PyCubed-Mini/avionics-solarpanels/README.md

# Solar Panels
PyCubedMini Solar Panel KiCAD projects.
