PyCubed-Mini/avionics-solarpanels/Solar-Panel-X (4L)/Solar-Panel-X.step

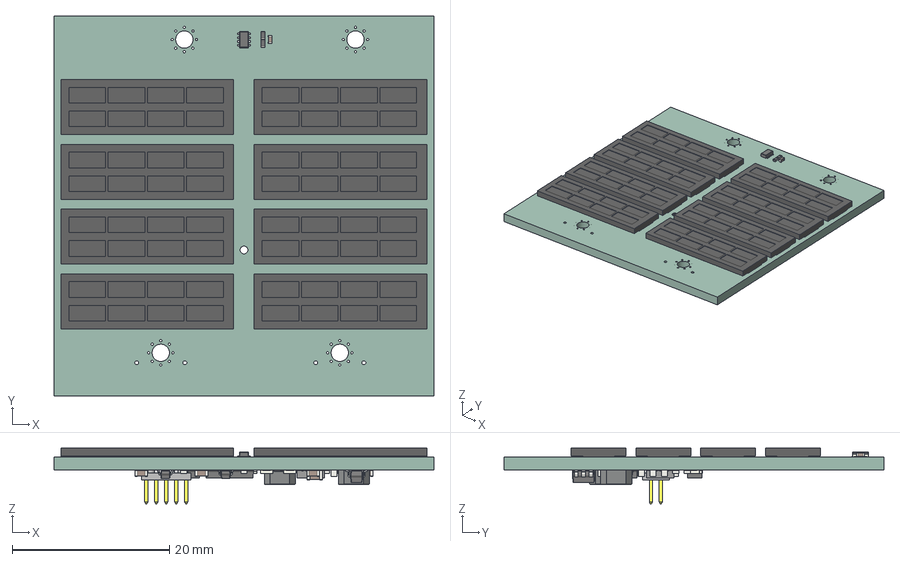
[picture p1: CAD file, 2023-06-21]
Solar-Panel-X (4L)/Solar-Panel-X.step
48.4 x 48.4 x 7.09 mm
Solar-Panel-X PCB
