PyCubed-Mini/avionics-solarpanels/Solar-Panel-X/Solar-Panel-X.step

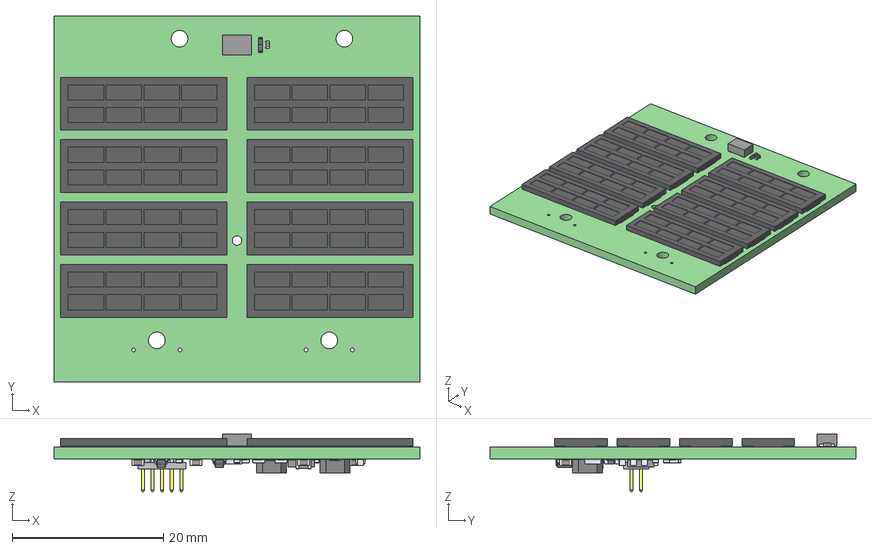
[picture p2: CAD file, 2022-12-01]
Solar-Panel-X/Solar-Panel-X.step
48.4 x 48.4 x 7.64 mm
Solar-Panel-X PCB
