PyCubed-Mini/avionics-solarpanels/Solar-Panel-Y+ (4L)/Solar-Panel-Y+.step

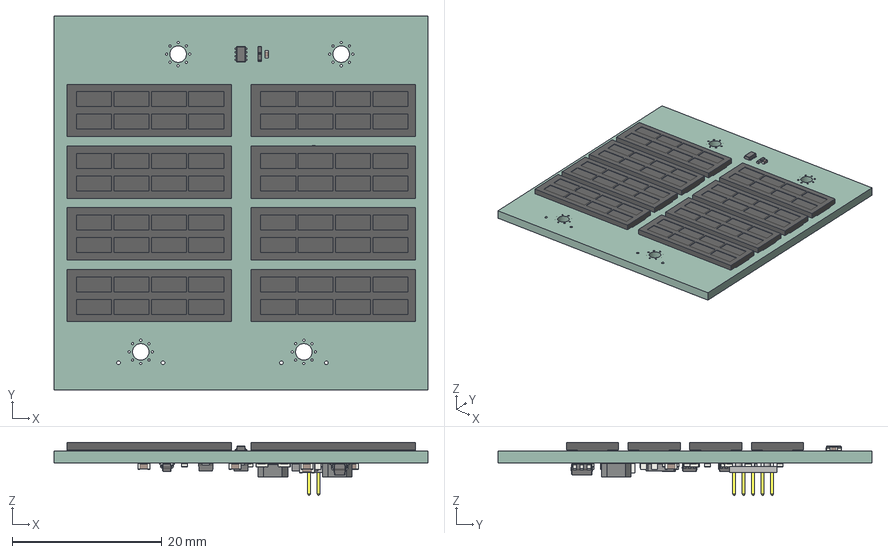
[picture p3: CAD file, 2023-06-21]
Solar-Panel-Y+ (4L)/Solar-Panel-Y+.step
50.0 x 50.0 x 7.09 mm
Solar-Panel-Y+ PCB
