PyCubed-Mini/avionics-solarpanels/Solar-Panel-Y+/Solar-Panel-Y+.step

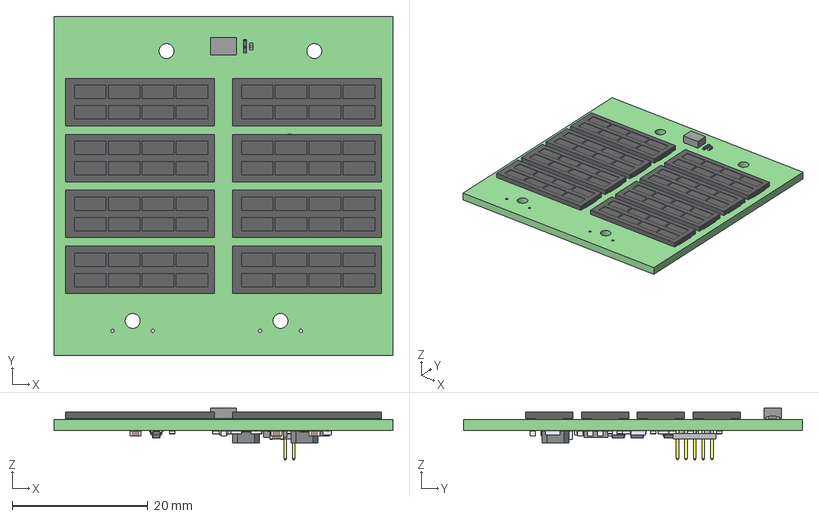
[picture p4: CAD file, 2022-12-01]
Solar-Panel-Y+/Solar-Panel-Y+.step
50.0 x 50.0 x 7.64 mm
Solar-Panel-Y+ PCB
