PyCubed-Mini/avionics-solarpanels/Solar-Panel-Z+ (4L)/Solar-Panel-Z+.step

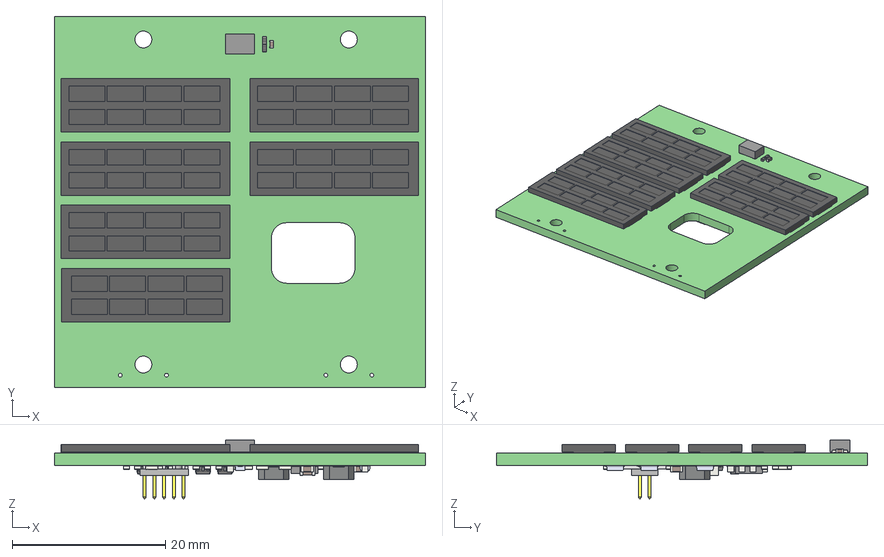
[picture p5: CAD file, 2022-12-01]
Solar-Panel-Z+ (4L)/Solar-Panel-Z+.step
48.4 x 48.4 x 7.64 mm
Solar-Panel-Z+ PCB
