PyCubed-Mini/avionics-solarpanels/Solar-Panel-Z+/Solar-Panel-Z+ Keepout.dxf

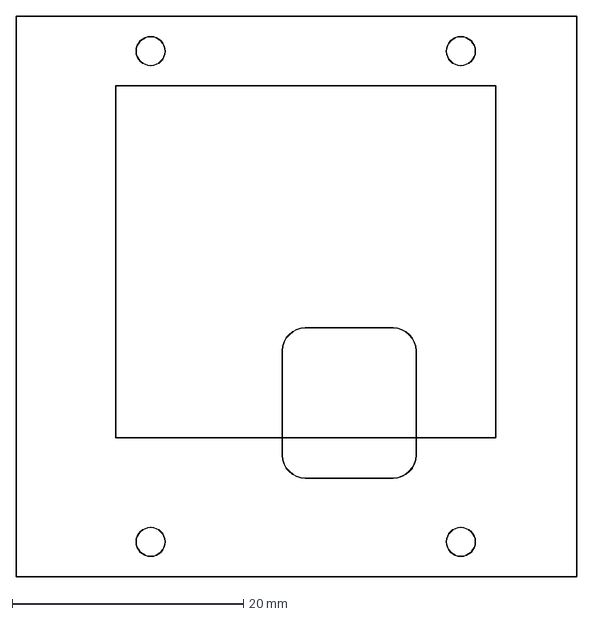
[picture p6: CAD file, 2022-08-09]
Solar-Panel-Z+/Solar-Panel-Z+ Keepout.dxf
48.4 x 48.4 mm
