PyCubed-Mini/avionics-solarpanels/Solar-Panel-Z+ (4L)/Solar-Panel-Z+.kicad_pcb

## KiCad design Solar-Panel-Z+ (4L)/Solar-Panel-Z+.kicad_pcb (2023-06-21)

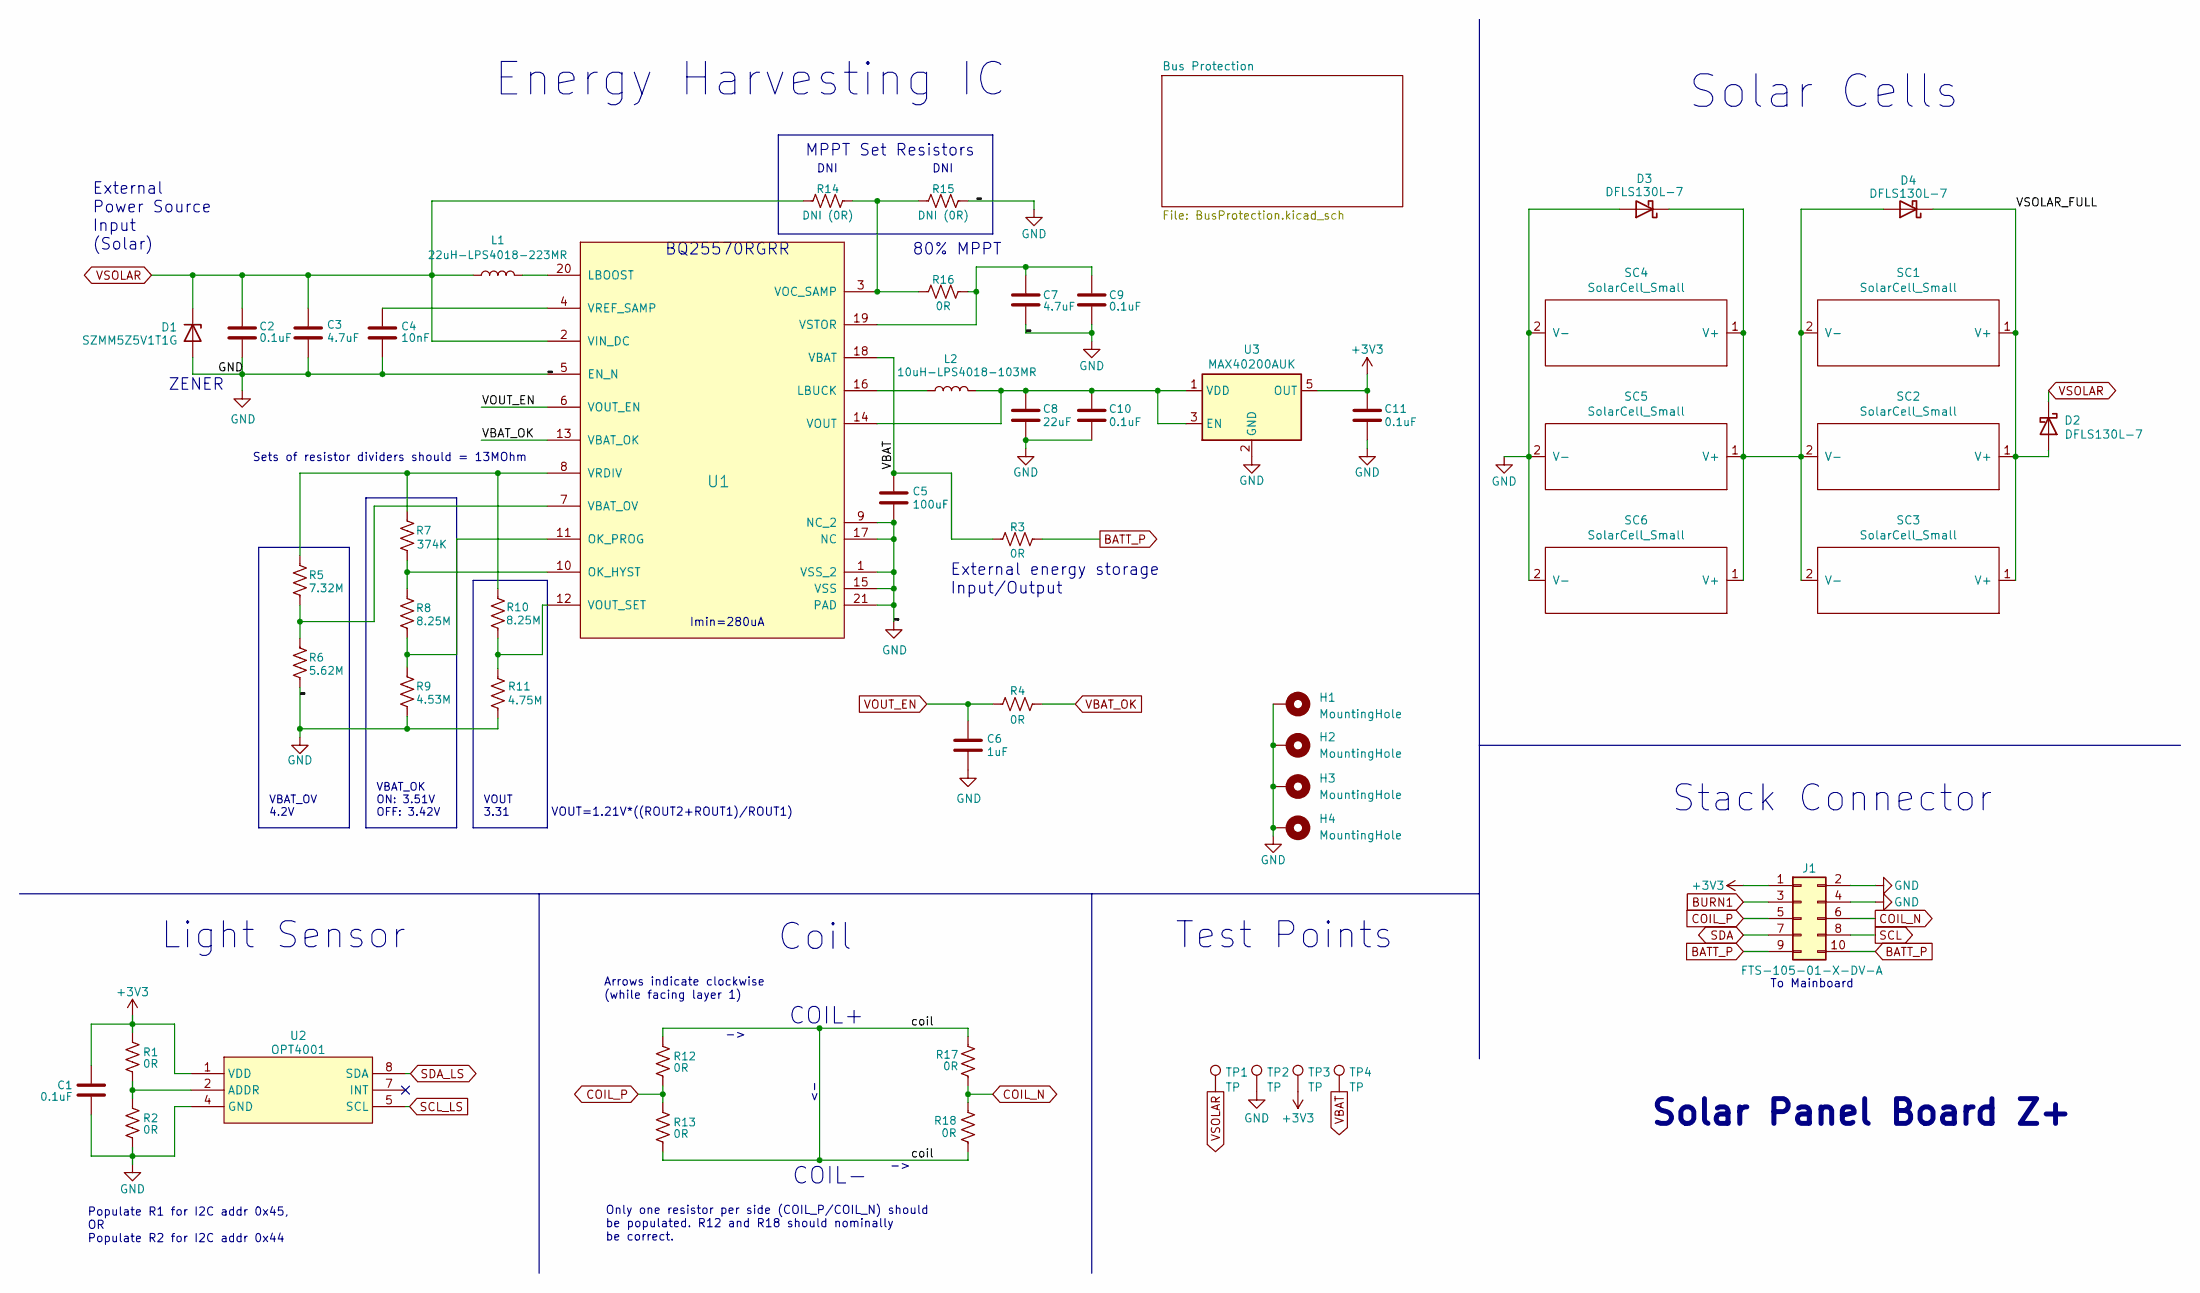
[picture p7: schematic Solar-Panel-Z+.kicad_sch, PyCubed Mini]

Parts:
C1: 0.1uF; C_0402_1005Metric
C2, C9, C10, C11: 0.1uF; C_0603_1608Metric
C3, C7: 4.7uF; C_0603_1608Metric
C4: 10nF; C_0603_1608Metric
C5: 100uF; C_0805_2012Metric
C6: 1uF; C_0603_1608Metric
C8: 22uF; C_0603_1608Metric
D1: SZMM5Z5V1T1G; D_SOD-523
D2, D3, D4: DFLS130L-7; D_PowerDI-123
H1, H2, H3, H4: MountingHole; MountingHole_2.2mm_M2_DIN965_Pad_TopBottom
J1: FTS-105-01-X-DV-A; SAMTEC-FTS-105-01-X-DV-A
L1: 22uH-LPS4018-223MR; LPS4018
L2: 10uH-LPS4018-103MR; LPS4018
R1, R2: 0R; R_0402_1005Metric
R3, R4, R12, R13, R16, R17, R18: 0R; R_0603_1608Metric
R5: 7.32M; R_0603_1608Metric
R6: 5.62M; R_0603_1608Metric
R7: 374K; R_0603_1608Metric
R8, R10: 8.25M; R_0603_1608Metric
R9: 4.53M; R_0603_1608Metric
R11: 4.75M; R_0603_1608Metric
R14, R15: DNI (0R); R_0603_1608Metric
SC1, SC2, SC3, SC4, SC5, SC6: SolarCell_Small; KXOB25-05X3F
TP1, TP2, TP3, TP4: TP; TestPoint_THTPad_D1.0mm_Drill0.5mm
U1: BQ25570RGRR; QFN50P350X350X100-21N-D
U2: OPT4001; SOT-583-8
U3: MAX40200AUK; SOT-23-5

Connections:
+3V3: C1.2, C11.1, J1.1, R1.2, TP3.1, U2.1 (VDD), U3.5 (OUT); also elsewhere on the board
/VSOLAR_FULL: D2.2 (A), D4.1 (K), SC1.1 (V+), SC2.1 (V+), SC3.1 (V+)
/coil: R12.2, R13.1, R17.2, R18.1
BATT_P: J1.9, J1.10, R3.1
BURN1: J1.3
COIL_N: J1.6, R17.1, R18.2
COIL_P: J1.5, R12.1, R13.2
GND: C1.1, C2.2, C3.2, C4.2, C5.2, C6.2, C7.2, C8.2, C9.2, C10.2, C11.2, D1.2 (A), D3.2 (A), H1.1, H2.1, H3.1, H4.1, J1.2, J1.4, R2.1, R6.1, R9.1, R11.1, R15.1, SC4.2 (V-), SC5.2 (V-), SC6.2 (V-), TP2.1, U1.1 (VSS_2), U1.5 (EN_N), U1.9 (NC_2), U1.15 (VSS), U1.17 (NC), U1.21 (PAD), U2.4 (GND), U3.2 (GND); also elsewhere on the board
unnamed: D3.1 (K), D4.2 (A), SC1.2 (V-), SC2.2 (V-), SC3.2 (V-), SC4.1 (V+), SC5.1 (V+), SC6.1 (V+)
unnamed: L1.2, U1.20 (LBOOST)
unnamed: L2.1, U1.16 (LBUCK)
unnamed: R7.1, R8.2, U1.10 (OK_HYST)
unnamed: R8.1, R9.2, U1.11 (OK_PROG)
unnamed: R5.1, R6.2, U1.7 (VBAT_OV)
unnamed: R14.1, R15.2, R16.2, U1.3 (VOC_SAMP)
unnamed: C8.1, C10.1, L2.2, U1.14 (VOUT), U3.1 (VDD), U3.3 (EN)
unnamed: R10.1, R11.2, U1.12 (VOUT_SET)
unnamed: R5.2, R7.2, R10.2, U1.8 (VRDIV)
unnamed: C4.1, U1.4 (VREF_SAMP)
unnamed: C7.1, C9.1, R16.1, U1.19 (VSTOR)
unnamed: R1.1, R2.2, U2.2 (ADDR)
SCL: J1.8; also elsewhere on the board
SCL_LS: U2.5 (SCL); also elsewhere on the board
SDA: J1.7; also elsewhere on the board
SDA_LS: U2.8 (SDA); also elsewhere on the board
VBAT: C5.1, R3.2, TP4.1, U1.18 (VBAT)
VBAT_OK: R4.1, U1.13 (VBAT_OK)
VOUT_EN: C6.1, R4.2, U1.6 (VOUT_EN)
VSOLAR: C2.1, C3.1, D1.1 (K), D2.1 (K), L1.1, R14.2, TP1.1, U1.2 (VIN_DC)

Notes on the sheet:
80% MPPT
DNI
Populate R1 for I2C addr 0x45, OR Populate R2 for I2C addr 0x44
Solar Cells
External Power Source Input (Solar)
Only one resistor per side (COIL_P/COIL_N) should be populated. R12 and R18 should nominally be correct.
Stack Connector
VOUT 3.31
Energy Harvesting IC
MPPT Set Resistors
Arrows indicate clockwise (while facing layer 1)
To Mainboard
Test Points
External energy storage Input/Output
COIL+
BQ25570RGRR
Light Sensor
Solar Panel Board Z+
VOUT=1.21V*((ROUT2+ROUT1)/ROUT1)
VBAT_OV 4.2V
VBAT_OK ON: 3.51V OFF: 3.42V
COIL-
Sets of resistor dividers should = 13MOhm
Imin=280uA
ZENER
Coil

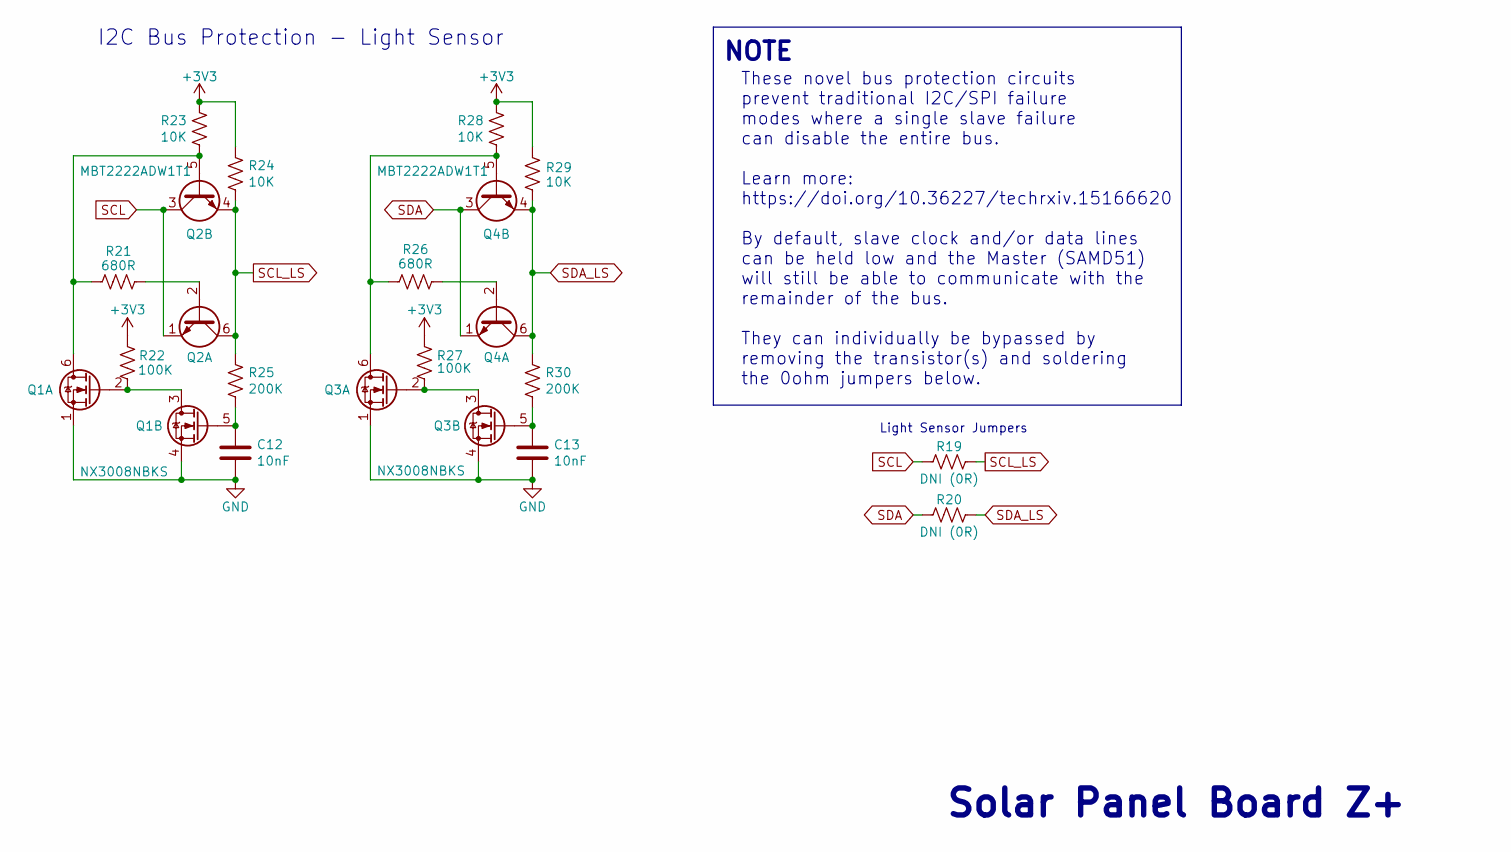
[picture p8: schematic BusProtection.kicad_sch, PyCubed Mini]

Parts:
C12, C13: 10nF; C_0603_1608Metric
Q1, Q3: NX3008NBKS; SOT-363_SC-70-6; Manufacturer_Part_Number NX3008NBKS
Q2, Q4: MBT2222ADW1T1; SOT-363_SC-70-6; Manufacturer_Part_Number MBT2222ADW1T1G
R19, R20: DNI (0R); R_0603_1608Metric
R21, R26: 680R; R_0603_1608Metric
R22, R27: 100K; R_0603_1608Metric
R23, R24, R28, R29: 10K; R_0603_1608Metric
R25, R30: 200K; R_0603_1608Metric

Connections:
+3V3: R22.1, R23.1, R24.1, R27.1, R28.1, R29.1; also elsewhere on the board
GND: C12.2, C13.2, Q1.1 (S2), Q1.4 (S1), Q3.1 (S2), Q3.4 (S1); also elsewhere on the board
unnamed: Q1.6 (D1), Q2.5 (B2), R21.2, R23.2
unnamed: Q1.2 (G2), Q1.3 (D2), R22.2
unnamed: C12.1, Q1.5 (G1), R25.2
unnamed: Q2.2 (B1), R21.1
unnamed: Q3.6 (D1), Q4.5 (B2), R26.2, R28.2
unnamed: Q3.2 (G2), Q3.3 (D2), R27.2
unnamed: C13.1, Q3.5 (G1), R30.2
unnamed: Q4.2 (B1), R26.1
SCL: Q2.1 (E1), Q2.3 (C2), R19.2; also elsewhere on the board
SCL_LS: Q2.4 (E2), Q2.6 (C1), R19.1, R24.2, R25.1; also elsewhere on the board
SDA: Q4.1 (E1), Q4.3 (C2), R20.2; also elsewhere on the board
SDA_LS: Q4.4 (E2), Q4.6 (C1), R20.1, R29.2, R30.1; also elsewhere on the board

Notes on the sheet:
Light Sensor Jumpers
These novel bus protection circuits prevent traditional I2C/SPI failure modes where a single slave failure can disable the entire bus. Learn more: https://doi.org/10.36227/techrxiv.15166620 By default, slave clock and/or data lines can be held low and the Master (SAMD51) will still be able to commu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
NOTE
I2C Bus Protection - Light Sensor
Solar Panel Board Z+

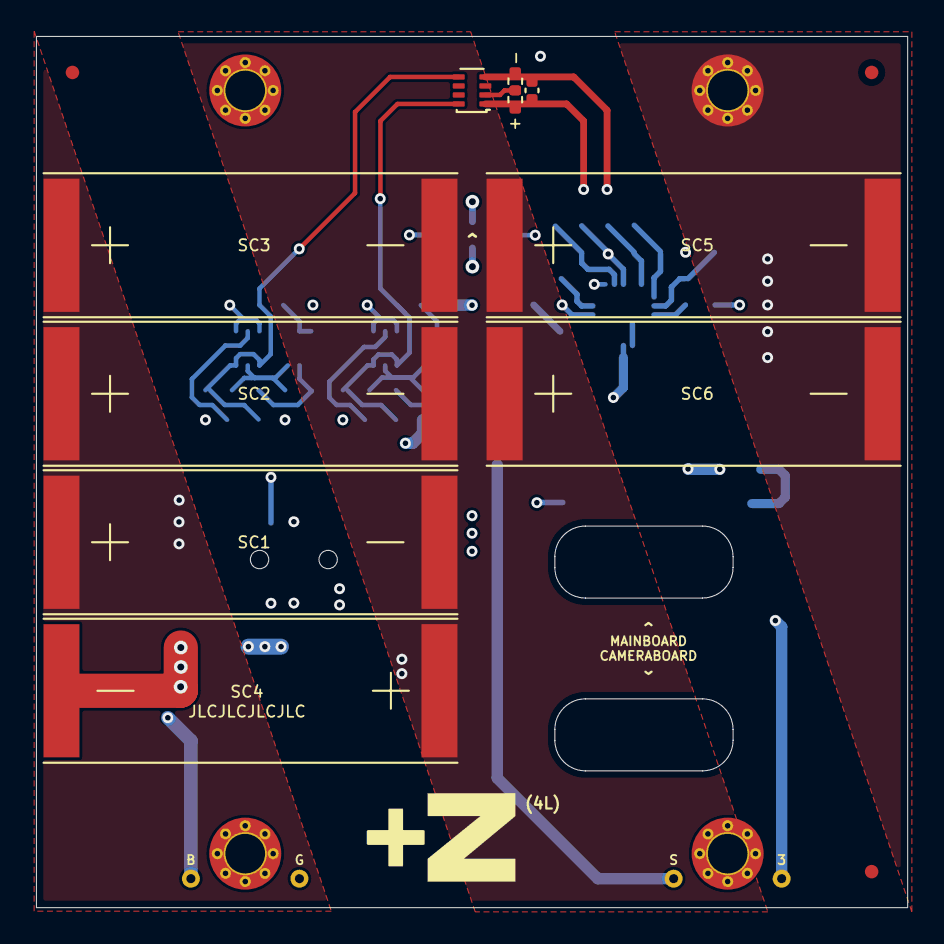
[picture p9: board Solar-Panel-Z+.kicad_pcb from above]

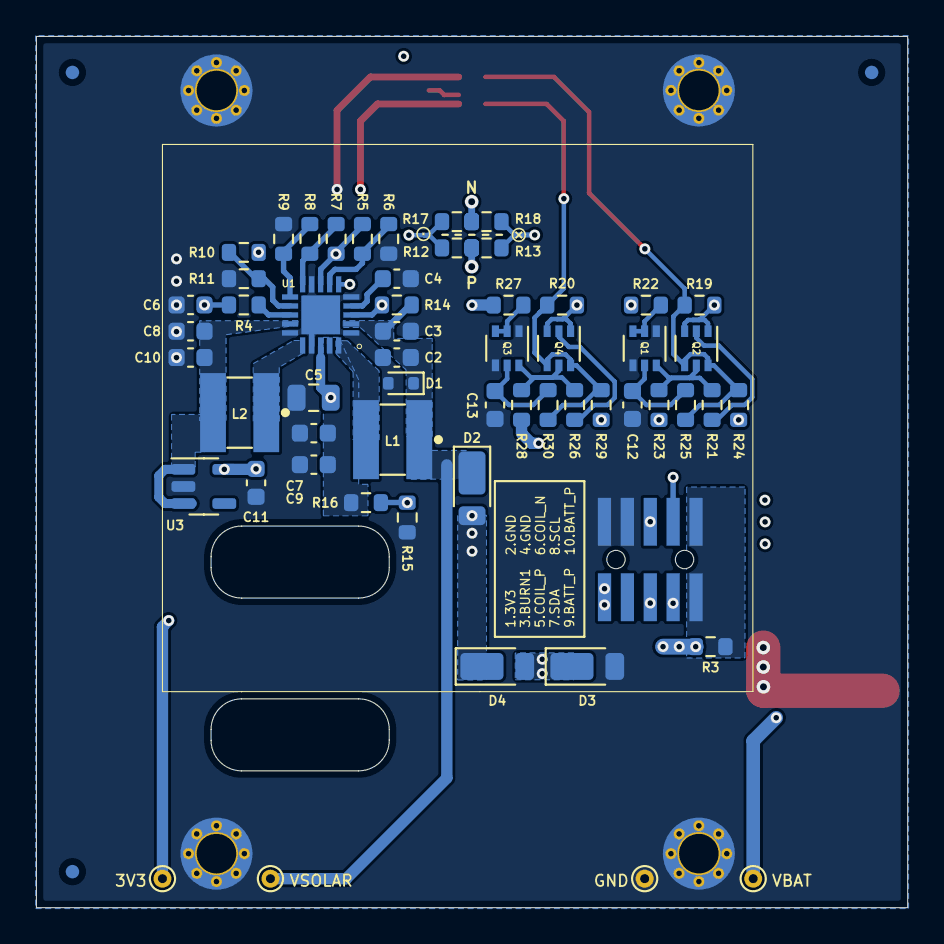
[picture p10: board Solar-Panel-Z+.kicad_pcb from below]

Board: 4 copper layers, 48.4 x 48.4 mm, 73 parts (58 on the bottom side), 36 nets.

Other parts of the board:
Ref**: Val**; ypanel
Ref**#2: Val**; pycubed_mini_half
