PyCubed-Mini/avionics-solarpanels/(threads)

Thread 2 (2022-02-15):

Initial electrical power-on test

jbwillis, 2022-02-15:
Test current board revisions by doing a flatsat assembly. Start by powering on the avionics board and seeing what runs, then connect each of the solar boards individually, then all of them together.

Closed 2022-06-13.

Thread 3 (2022-02-15):

Remove S-Band radio

jbwillis, 2022-02-15:

NeilKhera, 2022-02-28:
I assume this refers to the radio/antenna on the -Y board? Potentially addressed in #15

jbwillis, 2022-02-28:
Yes, that is correct.

Closed 2022-03-16.

Thread 4 (2022-02-15):

Consider adding GNSS

jbwillis, 2022-02-15:
Need to do a power analysis to see if we can even operate a GNSS antenna to make this work

jbwillis, 2022-02-22:
After a conversation with Zac, it sounds like we can rely on ground updates of the location and propagation using a clock.

Thread 6 (2022-02-15):

Determine status of current PCBs

jbwillis, 2022-02-15:
Compare the latest revision PCBs that we have with the schematics - determine if PCBs are up to date with the schematics.

Closed 2022-02-22.

Thread 8 (2022-02-15):

Battery harness redesign

jbwillis, 2022-02-15:
The current battery harness is bulky and time consuming to build, mostly due to having to route wires between each set of batteries. A revision of the battery harness, possibly including some small PCBs, would allow for easier construction and testing of the batteries.

jbwillis, 2022-02-22:
Some more thoughts and questions on how to do this.

- [ ] Could we use only one type of battery? The more square ones are 150 mAh and seem to fit into the space better.
- [ ] Solder two batteries to a little circuit board that plugs into the -Y board?

jbwillis, 2022-02-23:
Another idea - solder two batteries to the bottom half of each of the X and Z boards, getting rid of the battery donut entirely. This would require adding another power signal to the FFC to take power from the batteries to the sep switches. Bad idea? maybe.

NeilKhera, 2022-08-31:
Solved with Revision B

Closed 2022-08-31.

Thread 10 (2022-02-22):

Antenna redesign

jbwillis, 2022-02-22:

NeilKhera, 2022-02-28:
Do you have more info about this?

Closed 2022-05-24.

Thread 11 (2022-02-22):

Remove burn wire circuitry on Z boards?

jbwillis, 2022-02-22:
The burn circuit is currently unused on the Z board and it takes up valuable real estate. Consider removing it if possible

NeilKhera, 2022-02-27:
Should I proceed with this?

NeilKhera, 2022-02-28:
Done in #15. Will revert if necessary.

Closed 2022-03-16.

Thread 9 (2022-02-22):

Z Board access hole resize

jbwillis, 2022-02-22:
Need to make the access hole larger to enable easier access to USB port and to allow access to camera USB port.

- [ ] can we remove the fiducials on the z board and shift the solar panels all the way to the edge of the PCB?
- [ ] Extend hole down to even with solar cell below the hole.
- [ ] Make hole wider in each direction.

jbwillis, 2022-02-23:
This is also going to impact the magnetorquer coil routing on the Z board. However, I noticed that the Z coils stay within the mounting holes, whereas the X wrap around the outside of the mounting holes. So, the Z coils could wrap outside the holes, which would reduce the impact of the access hole.

NeilKhera, 2022-02-28:
I don't love the idea of have a big hole on two sides of the sat. Seems like a bad idea for contaminants and such entering the inner boards? Could we instead try to have some sort of external utility port which we can hook up to and breakout whatever we need?

jbwillis, 2022-02-28:
That's an interesting idea. It's pretty standard for cubesats to have one of these holes. I don't think there is a huge contaminant problem for us - I could see that being an issue for something like MoonRanger though. We also already have a massive hole that the camera protrudes through, so I'm not sure how much we'd gain by avoiding that on the Z board. Adding an external interface also adds extra complications for assembly and testing. Let's discuss this with @zacmanchester to get his final word.

Closed 2022-03-16.

Thread 12 (2022-02-23):

Flat Flex Connector Relocation

jbwillis, 2022-02-23:
Redesign the flat flex cable so it is easier to route.

- [x] Orient FFC connectors on the X and Z boards so they point towards +Y
- [x] Move FFC connector on -Y board so it doesn't interfere with battery box. Orient it so it points towards one of the outside edges. Probably best to have it point towards one of the X edges since the Z sides are more crowded.
- [x] Update 3D model with all revised boards and route flat flex cable - minimize bends/contorsions
- [ ] Revise flat flex cable circuit design

NeilKhera, 2022-02-28:
Relocation addressed in #15

Closed 2022-05-13.

Thread 13 (2022-02-23):

Z Board Component interference

jbwillis, 2022-02-23:
Capacitor C11 on Z board interferes with current battery donut. All components need to be shifted up (pcb coordinate -Y direction) by 3mm minimum (this may increase more)

NeilKhera, 2022-02-28:
Addressed in #15

Closed 2022-03-16.

Thread 14 (2022-02-23):

Burn wire holes on +Y board interfere with Z board

jbwillis, 2022-02-23:
Burn wire holes on +Y board should be shifted in to avoid interfering with Z board overlap. Shift in (pcb coordinates) 1mm in -X direction.

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

NeilKhera, 2022-02-28:
Addressed in #15

Closed 2022-03-16.

Thread 16 (2022-05-19):

Antenna RF test

jbwillis, 2022-05-19:
- [ ] Assemble RF and burn wire components on the -Z solar board
- [ ] Connect to mainboard
- [ ] Test transmitting in the lab using the antenna

NeilKhera, 2022-12-01:
Can we close this?

Closed 2022-12-28.

Thread 17 (2022-05-19):

Antenna burn wire test

jbwillis, 2022-05-19:
- [x] Assemble antennas and burn wire components on -Z board
- [x] Attach solar board to mainboard
- [x] Run code to activate burn wire
- [x] Check if burn wire is operating (loop some fishing line through the burn wire, add some tension, and see if it melts)
- [x] Wrap antennas around structure as if preparing for stowing, tie off to burn wire, activate burn wire and view antennas deploying (take a video)

Closed 2022-12-01.

Thread 18 (2022-05-31):

Increase Copper to Board Edge Distance to >= 15 mils (tentative)

NeilKhera, 2022-05-31:
OSHPark manufacturing may add a tiny ring of copper on the board edges which has caused shorts between copper fills on some of the solar panel boards. By keeping these pours further from the board edges, we can avoid that.

NeilKhera, 2022-08-31:
Resolved with Revision B

Closed 2022-08-31.

Thread 19 (2022-06-13):

Determine keepouts and board outlines from 3D model

jbwillis, 2022-06-13:
- [x] USB connector port
- [x] Camera hole in -Y board
- [x] Export board outline from Fusion360 as `<boardname>-outline.dxf`
- [x] Export keepout from Fusion360 as `<boardname>-keepout.dxf`

g-savant, 2022-06-17:
Finished keep outs, may revisit if too little space

Closed 2022-06-17.

Thread 27 (2022-07-08):

Z board stack updates

jbwillis, 2022-07-08:
Tasks to be completed for next revision of Z boards

- [x] Change board outline (getting new screw locations + access board location)
- [x] Change connector to match X solar boards, place connector where it will mate properly with the mainboard (should be same location as it is on the X boards)
- [x] Create new antenna footprint (based on observations from the previous one - larger size, different placement, etc.)
- [x] Create new burn wire layout to work with antenna layout
- [x] Re layout board to fit within new keepout zones
- [x] Consider how antenna wire will be routed to -Z board from mainboard
- [ ] Find a good spot near access port to add a reset button on the mainboard and add a hole in the +Z board to handle this.
- [x] Use silkscreen to label things in the access port
- [x] Add I2C bus protection circuit (see X board for reference)
- [x] Clean up Z board schematics, matching to X/Y schematics as much as possible
- [x] https://github.com/PyCubed-Mini/SolarPanels/issues/25
- [x] https://github.com/PyCubed-Mini/SolarPanels/issues/26

Closed 2022-12-01.

Thread 28 (2022-08-08):

Finalize and label light sensor addresses and I2C bus names

jbwillis, 2022-08-08:
- [ ] Each board should have an assigned I2C address for the light sensors. I believe this is already set in the code, we just need to label the boards and schematics with the correct address select option.
- [ ] Rather than use bus numbers on the solar boards, all solar board schematics should use the `SDA` and `SCL` net names.

Closed 2022-12-01.

Thread 29 (2022-08-09):

Battery Switches Wired Incorrectly

jbwillis, 2022-08-09:
Pole is the pin closest to the base of the lever. Normally Open is middle, Normally Closed is closest to the roller.

Closed 2022-10-09.

Thread 31 (2022-08-31):

Antenna Designs

jbwillis, 2022-08-31:
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
 A few ideas for different layouts to try for improved antenna performance.

Another idea is to try putting the balun on the top rather than the bottom of the board.

Closed 2022-10-09.

Thread 33 (2022-09-08):

Improve power path to burn wire

jbwillis, 2022-09-08:
We need wider power traces all the way through the stack.

- [ ] 50mil+ (as big as possible) traces (on the top/bottom layers, or 100mil+ on middle layers) on the -Y board between the connectors and switches for BATT_P, BATT_P_SW, BATT_N_SW, GND
- [ ] 50mil+ traces on the -Z board between the connectors and the burnwire circuit.

Closed 2022-12-01.

Thread 35 (2022-12-12):

-Z antenna wire silkscreen

jbwillis, 2022-12-12:
-Z antenna wire silkscreen misaligned, should be 1.6mm to the right in this image

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

Closed 2023-03-16.

Thread 37 (2022-12-28):

Revise low voltage management

jbwillis, 2022-12-28:
If VBAT_OK goes low while the radio (highest power device) is on, the MCU will get turned off and the radio will stay on.

Two options:
- allow the mcu to do all power management - VBAT_OK could be fed to the MCU
- use VBAT_OK to disconnect all devices from the batteries - this entails more than just disabling 3V3 since the radio and payload not on the 3V3 circuit. Perhaps we skip the harvester regulator and put a buck-boost converter on the mainboard for the MCU.

jbwillis, 2023-01-06:
Use the 3V3 line as a signal to turn off the high power line

Thread 38 (2023-01-13):

Add resistor between burn chip and burn wires and make it accessible on exterior of satellite.

jbwillis, 2023-01-13:

Closed 2023-03-16.

Thread 39 (2023-01-13):

Put burn wires in series

jbwillis, 2023-01-13:
Potentially make this selectable from the exterior of the satellite. But the default should be series

Closed 2023-03-16.

Thread 43 (2023-04-02):

Larger text for +Z access ports silkscreen

NeilKhera, 2023-04-02:

NeilKhera, 2023-04-27:
Fixed in Rev B3/02

Closed 2023-04-27.

Thread 45 (2023-04-04):

Fix light sensor capacitor value

NeilKhera, 2023-04-04:

NeilKhera, 2023-04-27:
Fixed in Rev B3/02

Closed 2023-04-27.
