PyCubed-Mini/avionics-solarpanels/(commit log)

2022-02-14 Solar-Panel--Y
    Adding cloned folder to Hardware Repository
    [ypanel-B_Mask.gbr, ypanel-B_Paste.gbr, ypanel-B_SilkS.gbr, ypanel-Bottom.gbr, ypanel-Edge_Cuts.gbr, ypanel-F_Mask.gbr, ypanel-F_Paste.gbr, ypanel-F_SilkS.gbr]
2022-02-14 Adding Solar Panel Minus and Plus Y Directories
    Cloned Original Folders
    [SolarCell+Y-B.Mask.gbr, SolarCell+Y-B.Paste.gbr, SolarCell+Y-B.SilkS.gbr, SolarCell+Y-Bottom.gbr, SolarCell+Y-Edge.Cuts.gbr, SolarCell+Y-F.Mask.gbr, SolarCell+Y-F.Paste.gbr, SolarCell+Y-F.SilkS.gbr]
2022-02-14 Adding Solar Panel X and Z Directories
    Cloned Original Repositories
    [SolarCellZ_v1-B.Mask.gbr, SolarCellZ_v1-B.Paste.gbr, SolarCellZ_v1-B.SilkS.gbr, SolarCellZ_v1-Bottom.gbr, SolarCellZ_v1-Edge.Cuts.gbr, SolarCellZ_v1-F.Mask.gbr, SolarCellZ_v1-F.Paste.gbr, SolarCellZ_v1-F.SilkS.gbr]
2022-02-14 Double Committed Solar Panel Minus Y Directory
    [ypanel-B_Mask.gbr, ypanel-B_Paste.gbr, ypanel-B_SilkS.gbr, ypanel-Bottom.gbr, ypanel-Edge_Cuts.gbr, ypanel-F_Mask.gbr, ypanel-F_Paste.gbr, ypanel-F_SilkS.gbr]
2022-02-14 Adding Solar Panel X
    Cloned Original Repository
    * removed archives from this commit because the number of files was too large. Will make another commit to add these
    [SolarCellX_v3-B.Mask.gbr, SolarCellX_v3-B.Paste.gbr, SolarCellX_v3-B.SilkS.gbr, SolarCellX_v3-Bottom.gbr, SolarCellX_v3-Edge.Cuts.gbr, SolarCellX_v3-F.Mask.gbr, SolarCellX_v3-F.Paste.gbr, SolarCellX_v3-F.SilkS.gbr]
2022-02-14 Solar Panel X Archives 1/5
    ** not added in the last commit due to a limit on the number of files that can be committed at once
    [SolarCellX_v1.kicad_pcb, SolarCellX_v1.sch]
2022-02-14 Solar Panel X Archives 2/5
    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
    [SolarCellX_v1.kicad_pcb, SolarCellX_v1.sch]
2022-02-14 Incorrect Directory
    [SolarCellX_v1.kicad_pcb, SolarCellX_v1.sch]
2022-02-14 Adding Archive Folder
    1/5
    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
    [SolarCellX_v1.kicad_pcb, SolarCellX_v1.sch]
2022-02-14 Adding Archive Folders
    2/5
    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
    [SolarCellX_v1.kicad_pcb, SolarCellX_v1.sch]
2022-02-14 Adding Archive Folder
    3/5
    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
    [SolarCell-X_v2.kicad_pcb, SolarCell-X_v2.sch]
2022-02-14 Adding Archive Folders
    4/5
    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
    [SolarCell+X_v2.kicad_pcb, SolarCell+X_v2.sch]
2022-02-14 Adding Archive Folder
    5/5
    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
    [SolarCellX_v3-B_Mask.gbr, SolarCellX_v3-B_Paste.gbr, SolarCellX_v3-B_SilkS.gbr, SolarCellX_v3-Bottom.gbr, SolarCellX_v3-Edge_Cuts.gbr, SolarCellX_v3-F_Mask.gbr, SolarCellX_v3-F_Paste.gbr, SolarCellX_v3-F_SilkS.gbr]
2022-02-16 Unnecessary
    Can access original solar panel X repository if we need to access these files.
    [SolarCell+X_v2.kicad_pcb, SolarCell+X_v2.sch, SolarCell-X_v2.kicad_pcb, SolarCell-X_v2.sch, SolarCellX_v1.kicad_pcb, SolarCellX_v1.sch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]
2022-02-20 -Y Board Changes
    [SolarCell-Y.kicad_pcb, SolarCell-Y.kicad_sch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]
2022-02-20 Added missing caps and fixed manufacturing error
    [SolarCell+Y-B.Mask.gbr, SolarCell+Y-B.Paste.gbr, SolarCell+Y-B.SilkS.gbr, SolarCell+Y-Bottom.gbr, SolarCell+Y-Edge.Cuts.gbr, SolarCell+Y-F.Mask.gbr, SolarCell+Y-F.Paste.gbr, SolarCell+Y-F.SilkS.gbr]
2022-02-24 More Cleanup
    [SolarCell+Y.kicad_pcb, SolarCell+Y.kicad_sch, SolarCell+Y.sch, SolarCell-Y.kicad_pcb, SolarCell.STEP, SolarCellX.kicad_pcb, SolarCellX.kicad_sch, SolarCellX.step]
2022-02-26 Finished Cleanup
    [SolarCell+Y.kicad_pcb, SolarCellZ.kicad_pcb, SolarCellZ.kicad_sch]
2022-02-28 Moved board connectors to North board edges
    [SolarCell+Y.kicad_pcb, SolarCell+Y.kicad_sch, SolarCell-Y.kicad_pcb, SolarCellX.kicad_pcb, SolarCellX.kicad_sch, SolarCellZ.kicad_pcb]
2022-02-28 Added JLC order number silkscreen
    [SolarCell+Y.kicad_pcb, SolarCell-Y.kicad_pcb, SolarCellX.kicad_pcb, SolarCellZ.kicad_pcb]
2022-03-04 Solar Panel Keepouts
    [SolarPanelMinusY_keepout.dxf, SolarPanelPlusY_keepout.dxf, SolarPanelX_keepout.dxf, SolarPanelZ_keepout.dxf]
2022-03-06 Made Requested Changes
    [SolarCell+Y.kicad_pcb, SolarCell+Y.kicad_sch, SolarCell+Z.kicad_pcb, SolarCell+Z.kicad_sch, SolarCell+Z_keepout.dxf, SolarCell-Y.kicad_pcb, SolarCell-Z.kicad_pcb, SolarCell-Z.kicad_sch]
2022-03-06 Removed .kicad_prl Files
2022-03-06 Removed *.kicad_prl files
2022-03-08 Done with X, +/-Y, and +Z. TODO: -Z
    [SolarCell+Z.kicad_pcb, SolarCell-Y.kicad_pcb, SolarCell-Z.kicad_pcb, SolarCell-Z.kicad_sch, SolarCellX.kicad_pcb]
2022-03-10 -Z board changes
    [SolarCell-Z.kicad_pcb, SolarCell-Z.kicad_sch]
2022-03-14 Cleaned up, exported step files
    [Solar-Panel-X.kicad_pcb, Solar-Panel-X.kicad_sch, Solar-Panel-Y+.kicad_pcb, Solar-Panel-Y+.kicad_sch, Solar-Panel-Y-.kicad_pcb, Solar-Panel-Y-.kicad_sch, Solar-Panel-Z+.kicad_pcb, Solar-Panel-Z+.kicad_sch]
2022-03-16 Exported Gerbers
    [Solar-Panel-X.kicad_pcb, Solar-Panel-X.kicad_sch, Solar-Panel-Y+.kicad_pcb, Solar-Panel-Y+.kicad_sch, Solar-Panel-Y-.kicad_pcb, Solar-Panel-Y-.kicad_sch, Solar-Panel-Z+.kicad_pcb, Solar-Panel-Z+.kicad_sch]
2022-06-14 Stack architecture schematic updates / fixes
    [Solar-Panel-X.kicad_sch, Solar-Panel-Y+.kicad_pcb, Solar-Panel-Y+.kicad_sch, Solar-Panel-Y-.kicad_sch, Solar-Panel-Z+.kicad_pcb, Solar-Panel-Z+.kicad_sch, Solar-Panel-Z-.kicad_sch]
2022-06-21 X board updates
    [Solar Board X+ Keep Outs.dxf, Solar Board X- Keep Outs.dxf, Solar-Panel-X.kicad_pcb, Solar-Panel-X.kicad_sch, Solar-Panel-Y-.kicad_sch]
2022-06-21 Added new keepouts
    [Solar Panel Y+ Keep outs.dxf, Solar Panel Z- Keep out.dxf, Solar Y- Keep Outs.dxf, Solar Z+ Keep Out.dxf]
2022-06-21 Added extra area for keep in zones
    [Solar Z+ Keep Out.dxf]
2022-06-29 X / Y+ board updates v04
    [Solar-Board-X+ Keepout.dxf, Solar-Board-X- Keepout.dxf, Solar-Panel-X.kicad_pcb, Solar-Panel-X.kicad_sch, Solar-Panel-Y+ Keepout.dxf, Solar-Panel-Y+.kicad_pcb, Solar-Panel-Y+.kicad_sch]
2022-06-29 Re-check boards, fixed connector pinouts, moved Y+ connector, re-export models
    [Solar-Panel-X.kicad_pcb, Solar-Panel-X.kicad_sch, Solar-Panel-Y+.kicad_pcb, Solar-Panel-Y+.kicad_sch, Solar-Panel-Y+.step]
2022-06-30 X Board Changes for new Y rails
    [Solar-Panel-X.kicad_pcb, Solar-Panel-X.step, Solar-Panel-Y+.kicad_sch, Solar-Panel-Y- Keepout.dxf, Solar-Panel-Y-.kicad_pcb, Solar-Panel-Y-.kicad_sch, SolarPanelY-.dxf]
2022-06-30 New X panel keepout
    [Solar-Board-X- Keepout.dxf, Solar-Panel-X_keepout.dxf]
2022-06-30 new keepout
    [Solar-Panel-Y- Keepout.dxf]
2022-07-01 New X board keepouts
    [Solar-Panel-X Keepout.dxf, Solar-Panel-X.kicad_pcb, Solar-Panel-X.step, Solar-Panel-Y+.kicad_pcb, SolarPanelY+_keepout.dxf]
2022-07-01 Re-distribute buses between layers
    [Solar-Panel-X.kicad_pcb, Solar-Panel-Y+.kicad_pcb]
2022-07-04 Finished Y- Board
    [Solar-Panel-X.kicad_pcb, Solar-Panel-X.step, Solar-Panel-Y+.kicad_pcb, Solar-Panel-Y-.kicad_pcb, Solar-Panel-Y-.kicad_sch]
2022-07-05 added X/Z board widths to keepout
    [Solar-Panel-Y- Keepout.dxf]
2022-07-05 Z board keepouts
    [Solar Panel Z- Keep out.dxf, Solar Z+ Keep Out.dxf]
2022-07-05 standardized keepout naming
    [Solar-Panel-Z+ Keepout.dxf, Solar-Panel-Z- Keepout.dxf]
2022-07-05 Made Suggested Y- changes
    [Solar-Panel-Y-.kicad_pcb, Solar-Panel-Y-.kicad_sch]
2022-07-05 Moved Charging connector, added text
    [Solar-Panel-Y-.kicad_pcb]
2022-07-05 New Y- Layout
    [Solar-Panel-Y-.kicad_pcb, Solar-Panel-Y-.kicad_sch]
2022-07-05 Ran KiCad Cleanup
    [Solar-Panel-Y-.kicad_pcb]
2022-07-06 Modified coil resistor layout on X board
    [Solar-Panel-X.kicad_pcb, Solar-Panel-X.kicad_sch]
2022-07-06 cleanup on X
    [Solar-Panel-X.kicad_pcb]
2022-07-06 Modified coil resistors to allow only one to be populated
    [Solar-Panel-Y+.kicad_pcb, Solar-Panel-Y+.kicad_sch]
2022-07-06 Modified coil resistors on Y- board
    [Solar-Panel-Y-.kicad_pcb, Solar-Panel-Y-.kicad_sch]
2022-07-06 Copper Fill cutouts on all layers
    [Solar-Panel-X.kicad_pcb, Solar-Panel-Y+.kicad_pcb, Solar-Panel-Y-.kicad_pcb]
2022-07-06 Export New Gerbers
    [Solar-Panel-X.kicad_pcb, Solar-Panel-Y+.kicad_pcb, Solar-Panel-Y-.kicad_pcb]
2022-07-17 Correct positions for everything except coils
    [Solar-Panel-Z-.kicad_pcb, Solar-Panel-Z-.kicad_sch]
2022-07-17 Added new edge cuts and connector
    [Solar-Panel-Z+.kicad_pcb, Solar-Panel-Z+.kicad_sch, Solar-Panel_keepouts_new.dxf]
2022-07-17 Retracing coils
    [Solar-Panel-Z-.kicad_pcb]
2022-07-18 added 3d models to fix paths
    [Solar-Panel-Z-.kicad_pcb]
2022-07-18 copied over top layer pieces
    [Solar-Panel-Z-.kicad_pcb]
2022-07-20 Added kicad libs
2022-07-21 Copied more of previous board
    [Solar-Panel-Z-.kicad_pcb]
2022-08-06 Added 4 Layer Z+ board
    [Solar-Panel-X.step, Solar-Panel-Z+ Keepout.dxf, Solar-Panel-Z+.kicad_pcb, Solar-Panel-Z+.kicad_sch, Solar-Panel-Z- Keepout.dxf, Solar-Panel-Z-.kicad_pcb, Solar-Panel-Z-.kicad_sch, SolarPanelZ+_keepout.dxf]
2022-08-06 Added 4 Layer Z- board
    [Solar-Panel-Z+.kicad_pcb, Solar-Panel-Z-.kicad_pcb, Solar-Panel-Z-.kicad_sch]
2022-08-08 Z board updates
    [Solar-Panel-X.step, Solar-Panel-Z+.kicad_pcb, Solar-Panel-Z+.step, Solar-Panel-Z-.kicad_pcb, Solar-Panel-Z-.kicad_sch]
2022-08-31 Removed submodule Solar-Panel-Z-/kicad-libs
2022-09-02 Finished Y- 4 Layer Board
    [Solar-Panel-X.kicad_pcb, Solar-Panel-Y- Keepout.dxf, Solar-Panel-Y-.kicad_pcb, Solar-Panel-Y-.kicad_sch]
2022-09-02 Library updates
    [Solar-Panel-Y-.kicad_pcb]
2022-09-03 Z- board antenna updates
    [Solar-Panel-Y-.kicad_pcb, Solar-Panel-Y-.kicad_sch, Solar-Panel-Z-.kicad_pcb, Solar-Panel-Z-.kicad_sch]
2022-09-05 Added New Z+ Solar Panels
    [Solar-Panel-Z- Keepout.dxf, Solar-Panel-Z-.kicad_pcb, Solar-Panel-Z-.kicad_sch]
2022-09-06 New Y- and Z- boards
    [Solar-Panel-Y-.kicad_pcb, Solar-Panel-Y-.kicad_sch, Solar-Panel-Z-.kicad_pcb, Solar-Panel-Z-.kicad_sch]
2022-09-06 Resized Copper Pours
    [Solar-Panel-Y-.kicad_pcb]
2022-09-08 Added antenna cable silkscreen lines
    [Solar-Panel-Z-.kicad_pcb]
2022-09-08 Modify antenna silkscreen lines to make it match where the slot on the bottom battery board will go
    [Solar-Panel-Z-.kicad_pcb]
2022-09-08 Widened Power Traces on Y- Boards
    [Solar-Panel-Y-.kicad_pcb]
2022-09-13 Exported Files
    [Solar-Panel-Y-.kicad_pcb, Solar-Panel-Z-.kicad_pcb]
2022-10-09 Moved Access Port for new USBC location
    [Solar-Panel-Z+.kicad_pcb]
2022-10-09 Update kicad_libs
2022-11-09 Updated all solar panels to Rev B2/01 + Export STEP / BOM
    [Solar-Panel-X Keepout.dxf, Solar-Panel-X.kicad_pcb, Solar-Panel-X.kicad_sch, Solar-Panel-X.step, Solar-Panel-Y+ Keepout.dxf, Solar-Panel-Y+.kicad_pcb, Solar-Panel-Y+.kicad_sch, Solar-Panel-Y+.step]
2022-11-10 DFM updates and repositioned -Z mounting holes
    [Solar-Panel-X.kicad_pcb, Solar-Panel-Y+.kicad_pcb, Solar-Panel-Y-.kicad_pcb, Solar-Panel-Z+.kicad_pcb, Solar-Panel-Z-.kicad_pcb]
2022-11-11 Fix Rail Interference issues
    [Solar-Panel-Y+.kicad_pcb, Solar-Panel-Y-.kicad_pcb]
2022-11-11 Export new STEP files
    [Solar-Panel-Y+.step]
2022-11-11 Export Gerbers
    [Solar-Panel-X.kicad_pcb, Solar-Panel-Y+.kicad_pcb, Solar-Panel-Y-.kicad_pcb, Solar-Panel-Z+.kicad_pcb, Solar-Panel-Z-.kicad_pcb]
2022-11-13 Finish 6 Layer panel versions
    [Solar-Panel-X.kicad_pcb, Solar-Panel-X.kicad_sch, Solar-Panel-X.step, Solar-Panel-Y+.kicad_pcb, Solar-Panel-Y+.kicad_sch, Solar-Panel-Y+.step, Solar-Panel-Y-.kicad_pcb, Solar-Panel-Y-.kicad_sch]
2023-02-11 Changed design to TSL2691 and IRF7404 on Z- (4L)
    [Solar-Panel-Z-.kicad_pcb, Solar-Panel-Z-.kicad_sch]
2023-02-18 Changed TSL2591 to BH1750
    All boards (4L) except -Y
    [Solar-Panel-X.kicad_pcb, Solar-Panel-X.kicad_sch, Solar-Panel-Y+.kicad_pcb, Solar-Panel-Y+.kicad_sch, Solar-Panel-Z+.kicad_pcb, Solar-Panel-Z+.kicad_sch, Solar-Panel-Z-.kicad_pcb, Solar-Panel-Z-.kicad_sch]
2023-02-19 Y- board changes for Rev B3/01
    [BusProtection.kicad_sch, Solar-Panel-Y-.kicad_pcb, Solar-Panel-Y-.kicad_sch]
2023-02-25 Updated light sensor to OPT 3001, Updated solar diodes.
    [BusProtection.kicad_sch, Solar-Panel-X.kicad_pcb, Solar-Panel-X.kicad_sch, Solar-Panel-X.step, Solar-Panel-Y+.kicad_pcb, Solar-Panel-Y+.kicad_sch, Solar-Panel-Y+.step, Solar-Panel-Y-.kicad_pcb]
2023-02-25 Silkscreen fix for -Z antenna wire
    [Solar-Panel-Z-.kicad_pcb]
2023-02-25 More silkscreen cleanup
    [Solar-Panel-Z-.kicad_pcb]
2023-02-26 Removed gerbers from repo
2023-03-16 Updated Mounting Holes
    [Solar-Panel-X Keepout.dxf, Solar-Panel-X.kicad_pcb, Solar-Panel-Y+ Keepout.dxf, Solar-Panel-Y+.kicad_pcb, Solar-Panel-Y- Keepout.dxf, Solar-Panel-Y-.kicad_pcb, Solar-Panel-Y-.kicad_sch, Solar-Panel-Z+ Keepout.dxf]
2023-04-27 B3/02 Updates
    [BusProtection.kicad_sch, Solar-Panel-X.kicad_pcb, Solar-Panel-X.kicad_sch, Solar-Panel-X.step, Solar-Panel-Y+.kicad_pcb, Solar-Panel-Y+.kicad_sch, Solar-Panel-Y-.kicad_pcb, Solar-Panel-Y-.kicad_sch]
2023-04-27 Minor Fixes
    [Solar-Panel-Y-.kicad_pcb, Solar-Panel-Y-.kicad_sch, Solar-Panel-Z-.kicad_pcb, Solar-Panel-Z-.kicad_sch]
2023-04-30 Minor placement updates on -Y board
    [Solar-Panel-Y-.kicad_pcb]
2023-05-28 Updated Sun Sensor to OPT4001
    [Solar-Panel-X.kicad_pcb, Solar-Panel-X.kicad_sch, Solar-Panel-Y+.kicad_pcb, Solar-Panel-Y+.kicad_sch, Solar-Panel-Y-.kicad_pcb, Solar-Panel-Y-.kicad_sch, Solar-Panel-Z+.kicad_pcb, Solar-Panel-Z+.kicad_sch]
2023-06-19 Moved -Y switches out 1mm
    [Solar-Panel-X.kicad_pcb, Solar-Panel-X.step, Solar-Panel-Y+.kicad_pcb, Solar-Panel-Y+.step, Solar-Panel-Y-.kicad_pcb, Solar-Panel-Z+.kicad_pcb, Solar-Panel-Z-.kicad_pcb]
2023-06-19 Updated Rev to B3/03
    [BusProtection.kicad_sch, Solar-Panel-X.kicad_pcb, Solar-Panel-X.kicad_sch, Solar-Panel-Y+.kicad_pcb, Solar-Panel-Y+.kicad_sch, Solar-Panel-Y-.kicad_pcb, Solar-Panel-Y-.kicad_sch, Solar-Panel-Z+.kicad_pcb]
2023-06-19 Pull kicad-libs
2023-06-21 Exported stuff
    [Solar-Panel-X.kicad_pcb, Solar-Panel-Y+.kicad_pcb, Solar-Panel-Y-.kicad_pcb, Solar-Panel-Z+.kicad_pcb, Solar-Panel-Z-.kicad_pcb]
